Cherrytree56567/Creative-Pad/README.md

# Creative Pad
A simple Macropad which has Hotswap Kailh Switches with custom key binds.

## Features
 - Hotswap Kailh Switches
 - MX Switches
 - RP2040
 - LCD Screen
 - FPC Connector

## Goals
 - Proper support with Ableton
