Cherrytree56567/Creative-Pad/src/KiCad/3dmodels/KH-TYPE-C-16P.step

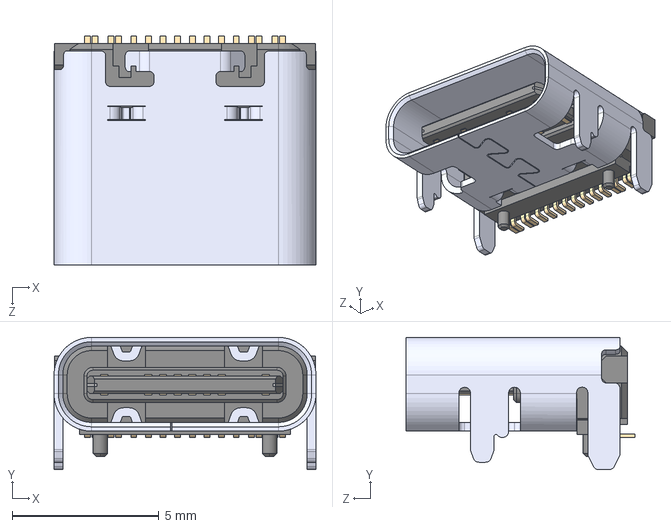
[picture p1: CAD file, 2025-08-07]
src/KiCad/3dmodels/KH-TYPE-C-16P.step
8.94 x 4.51 x 7.81 mm
