Cherrytree56567/Creative-Pad/src/KiCad/3dmodels/USB4110GFA.step

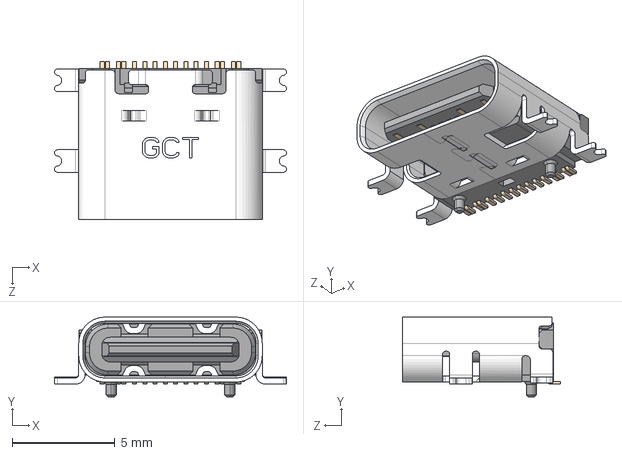
[picture p2: CAD file, 2025-08-07]
src/KiCad/3dmodels/USB4110GFA.step
11.3 x 3.89 x 7.70 mm
