Cherrytree56567/Creative-Pad/src/KiCad/3dmodels/RP2040.step

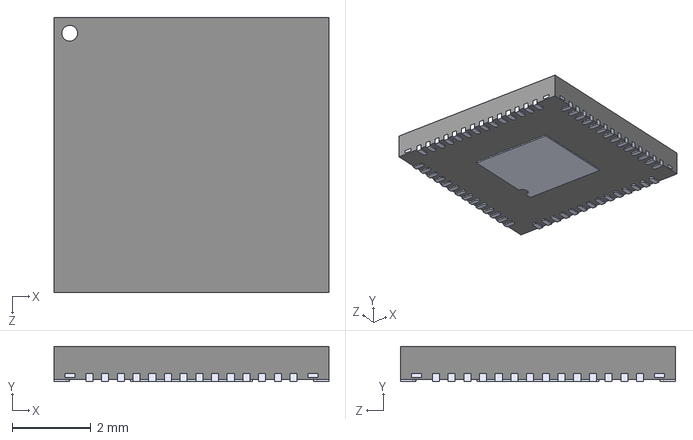
[picture p3: CAD file, 2025-08-07]
src/KiCad/3dmodels/RP2040.step
7.00 x 0.9 x 7.00 mm
