Cherrytree56567/Creative-Pad/schematic.pdf

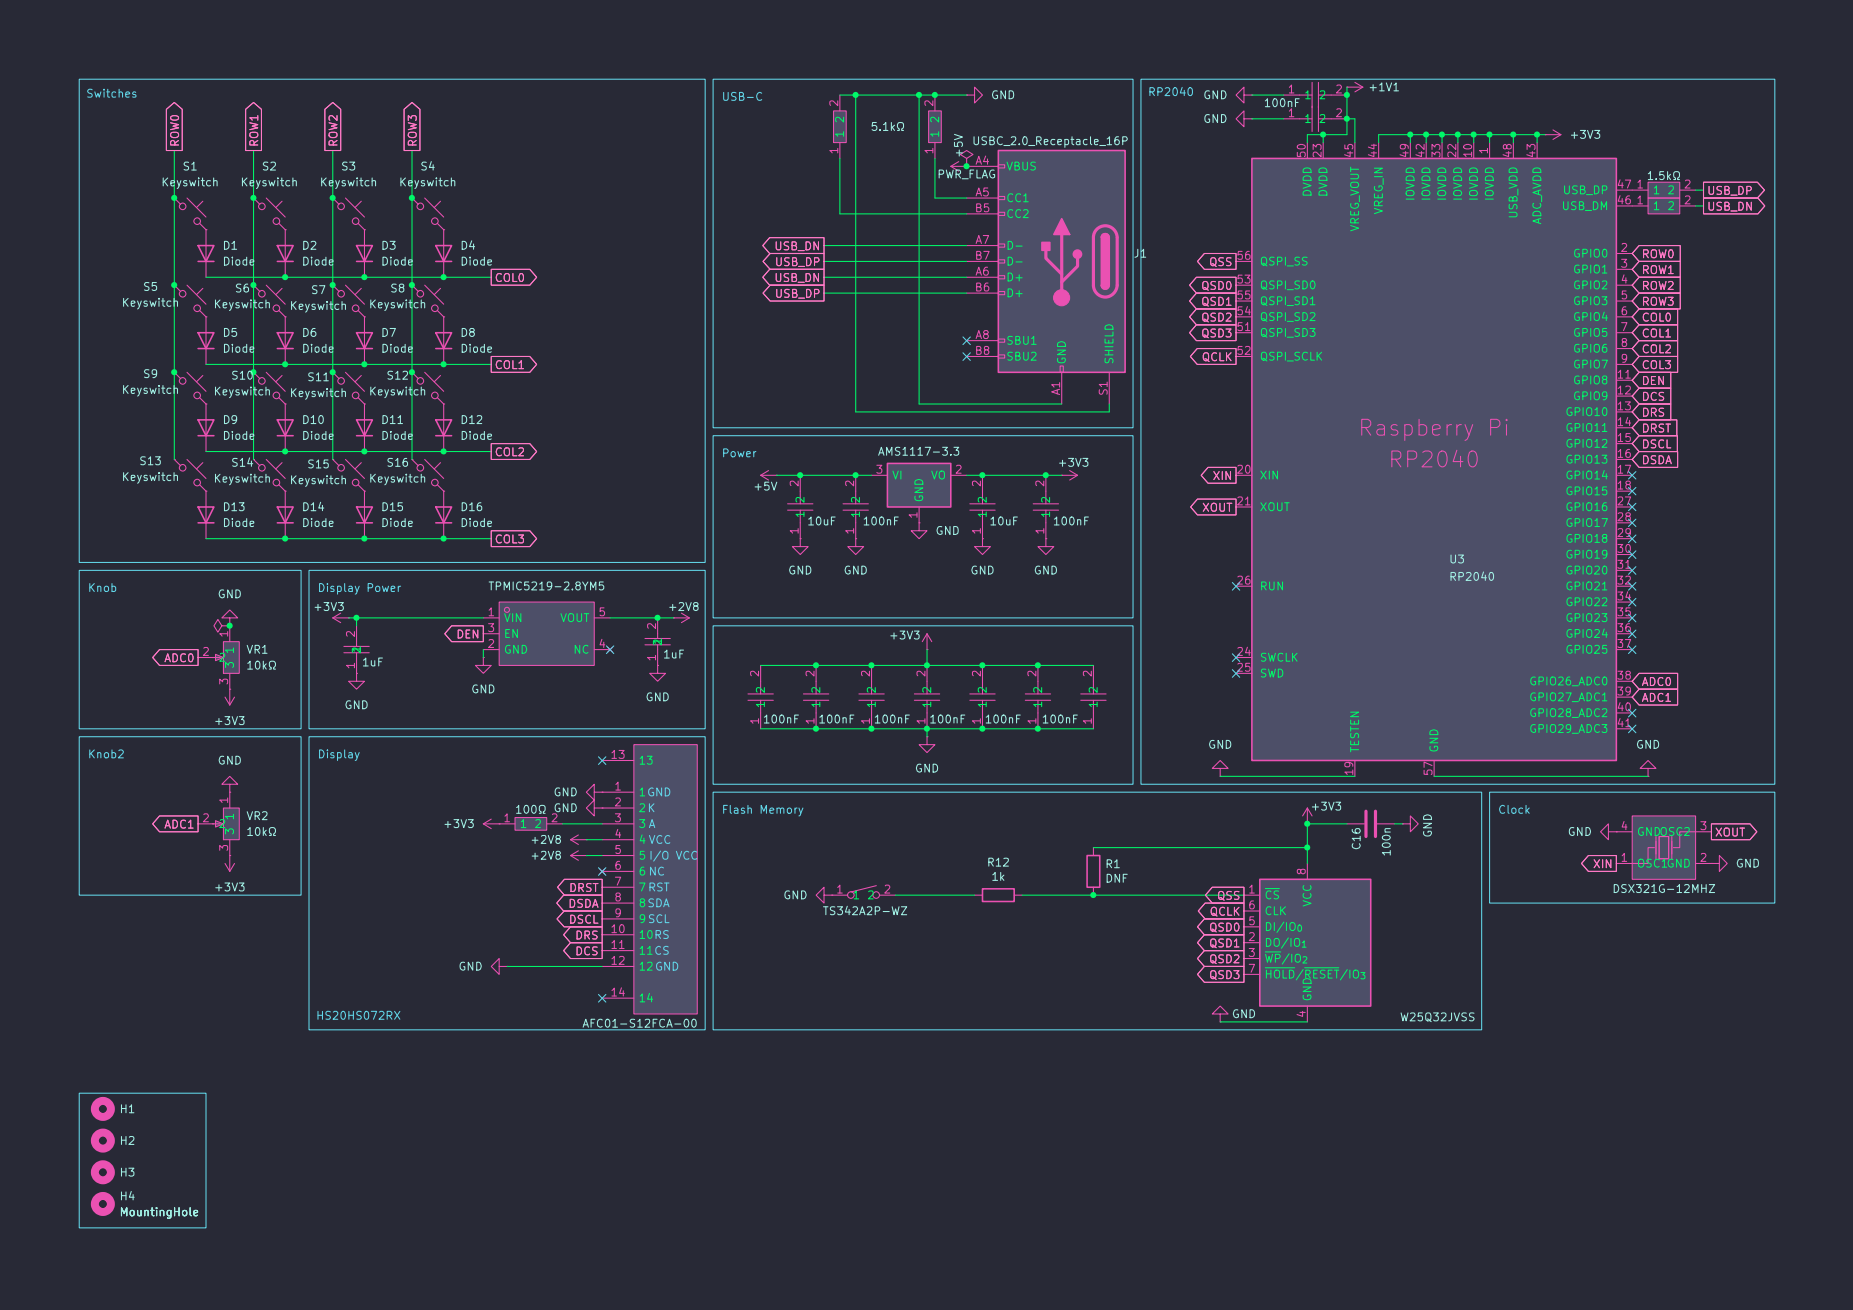
[picture p4: page 1]
