Cherrytree56567/Creative-Pad/src/CreativePad.kicad_pcb

## KiCad design src/CreativePad.kicad_pcb (2025-08-08)

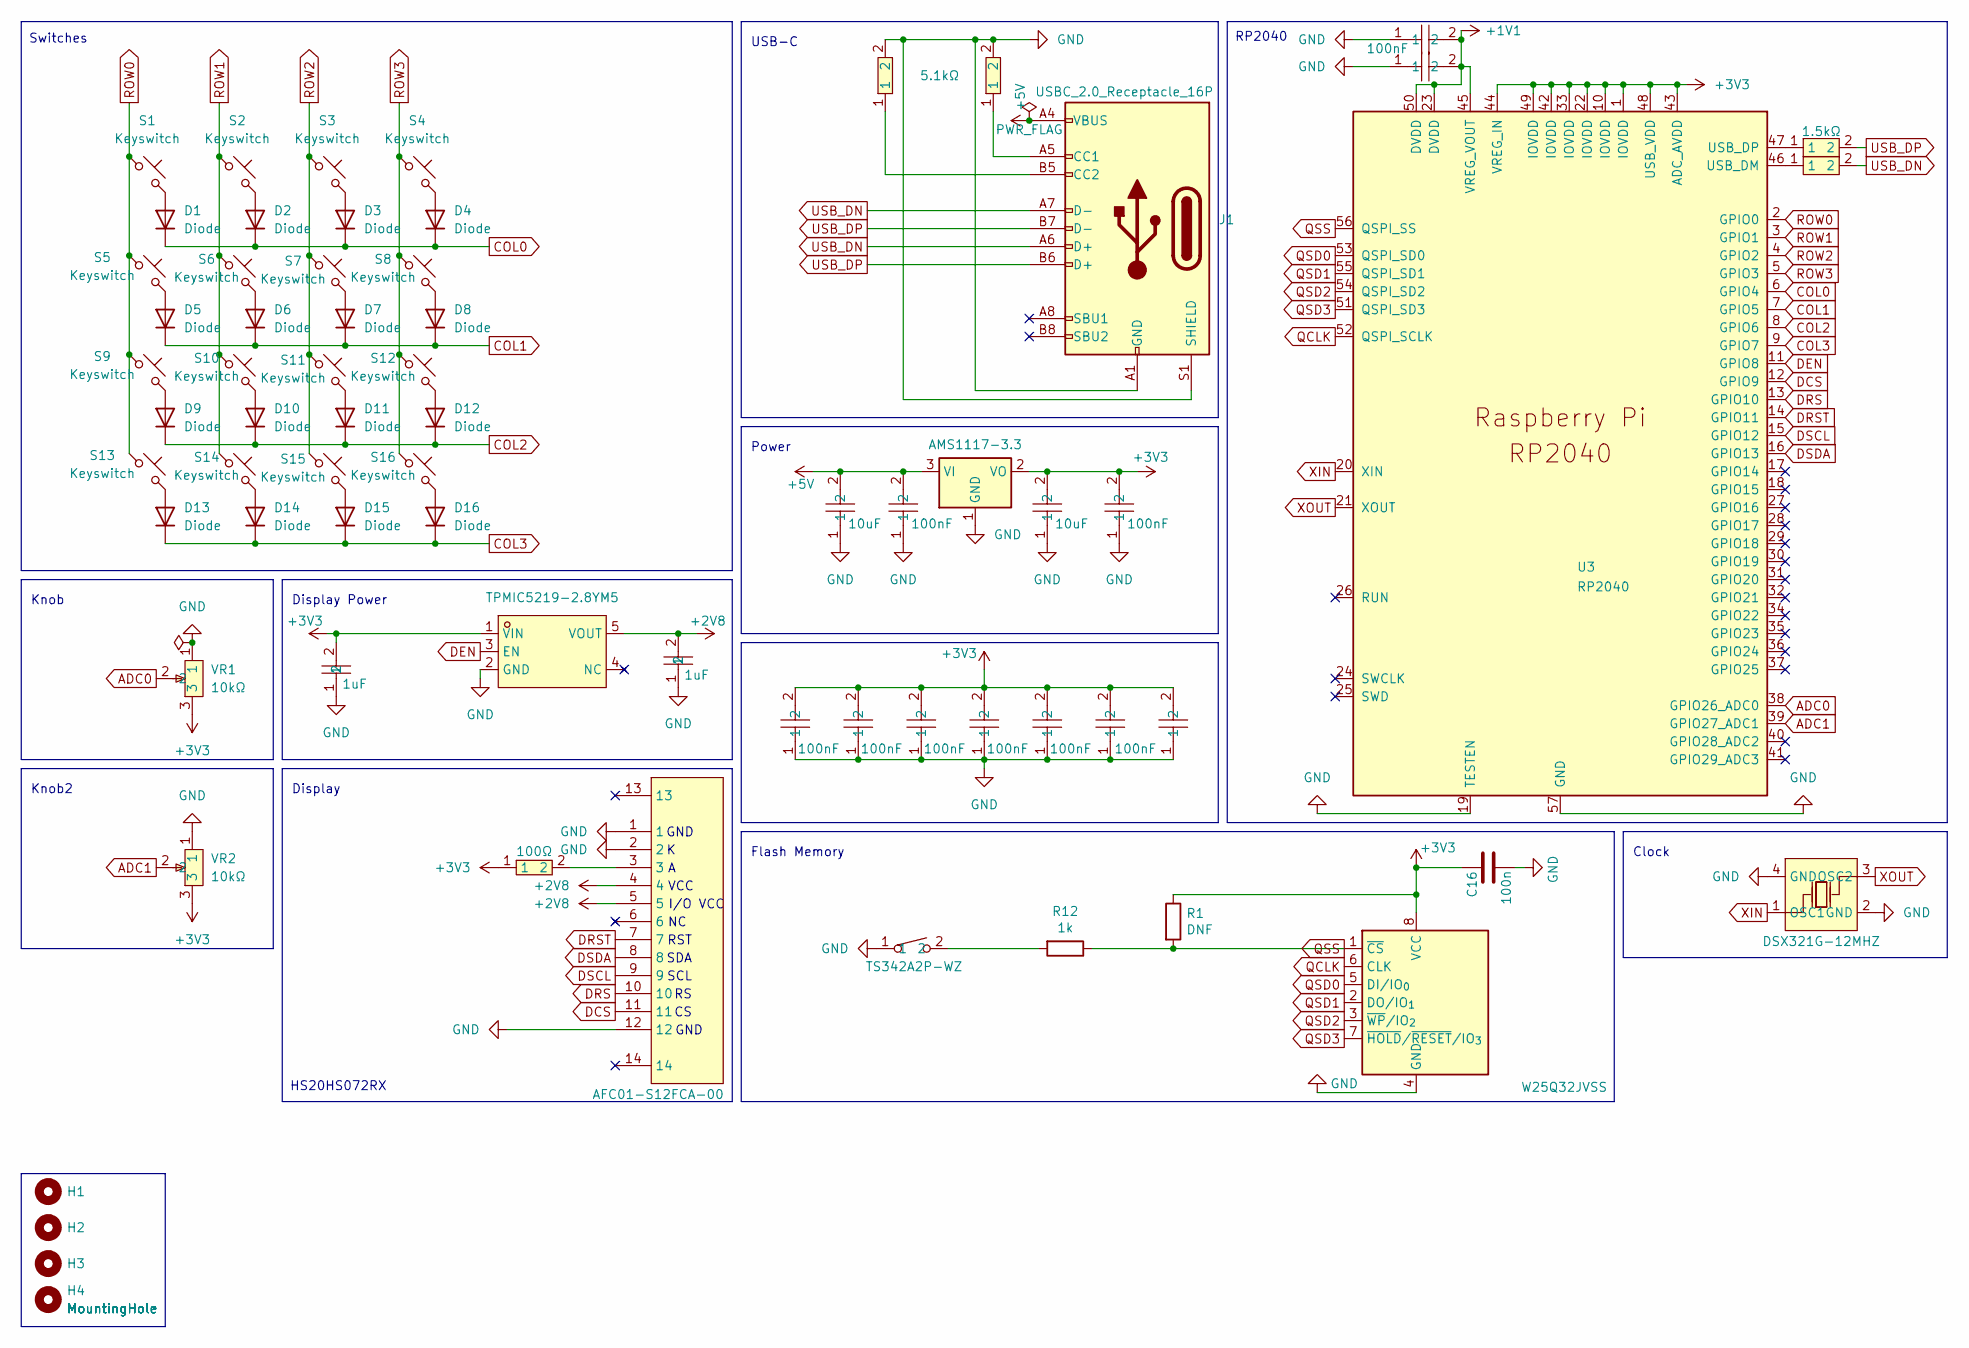
[picture p5: schematic CreativePad.kicad_sch, Creative Pad]

Parts:
C1, C4: 10uF; C0603; LCSC Part C1691
C2, C3, C5, C6, C7, C8, C9, C10, C13, C14, C17: 100nF; C0603; LCSC Part C14663
C12, C15: 1uF; C0402; LCSC Part C14445
C16: 100n; C_0402_1005Metric
D1, D2, D3, D4, D5, D6, D7, D8, D9, D10, D11, D12, D13, D14, D15, D16: Diode; Diode_DO-35
FPC1: AFC01-S12FCA-00; FPC-SMD_AFC01-S12FCA-00; LCSC Part C262661
H1, H2, H3, H4: MountingHole; MountingHole_2.2mm_M2
J1: USBC_2.0_Receptacle_16P; USB_C_Receptacle_HCTL_HC-TYPE-C-16P-01A
R1: DNF; R_0402_1005Metric
R2, R6: 1.5kΩ; R0603; LCSC Part C2907083
R4, R9: 5.1kΩ; R0603; LCSC Part C105580
R8: 100Ω; R0402; LCSC Part C25076
R12: 1k; R_0402_1005Metric
S1, S2, S3, S4, S5, S6, S7, S8, S9, S10, S11, S12, S13, S14, S15, S16: Keyswitch; SW_Hotswap_Kailh_MX_1.00u
SW1: TS342A2P-WZ; SW-SMD_L4.0-W2.9-LS5.0; LCSC Part C557591
U1: TPMIC5219-2.8YM5; SOT-23-5_L2.9-W1.6-P0.95-LS2.8-BR; LCSC Part C18212650
U2: AMS1117-3.3; SOT-223-3_TabPin2
U3: RP2040; RP2040-QFN-56
U5: W25Q32JVSS; SOIC-8_5.3x5.3mm_P1.27mm
VR1, VR2: 10kΩ; RES-ADJ-TH_3362P; LCSC Part C58159
X2: DSX321G-12MHZ; CRYSTAL-SMD_4P-L3.2-W2.5-BL; LCSC Part C93234

Connections:
+1V1: C13.2, C17.2, U3.23 (DVDD), U3.45 (VREG_VOUT), U3.50 (DVDD)
+2V8: C12.2, FPC1.4, FPC1.5, U1.5 (VOUT)
+3V3: C3.2, C4.2, C5.2, C6.2, C7.2, C8.2, C9.2, C10.2, C14.2, C15.2, C16.1, R1.1, R8.1, U1.1 (VIN), U2.2 (VO), U3.1 (IOVDD), U3.10 (IOVDD), U3.22 (IOVDD), U3.33 (IOVDD), U3.42 (IOVDD), U3.43 (ADC_AVDD), U3.44 (VREG_IN), U3.48 (USB_VDD), U3.49 (IOVDD), U5.8 (VCC), VR1.3, VR2.3
+5V: C1.2, C2.2, J1.A4 (VBUS), J1.A9 (VBUS), J1.B4 (VBUS), J1.B9 (VBUS), U2.3 (VI)
ADC0: U3.38 (GPIO26_ADC0), VR1.2
ADC1: U3.39 (GPIO27_ADC1), VR2.2
COL0: D1.1 (K), D2.1 (K), D3.1 (K), D4.1 (K), U3.6 (GPIO4)
COL1: D5.1 (K), D6.1 (K), D7.1 (K), D8.1 (K), U3.7 (GPIO5)
COL2: D9.1 (K), D10.1 (K), D11.1 (K), D12.1 (K), U3.8 (GPIO6)
COL3: D13.1 (K), D14.1 (K), D15.1 (K), D16.1 (K), U3.9 (GPIO7)
DCS: FPC1.11, U3.12 (GPIO9)
DEN: U1.3 (EN), U3.11 (GPIO8)
DRS: FPC1.10, U3.13 (GPIO10)
DRST: FPC1.7, U3.14 (GPIO11)
DSCL: FPC1.9, U3.15 (GPIO12)
DSDA: FPC1.8, U3.16 (GPIO13)
GND: C1.1, C2.1, C3.1, C4.1, C5.1, C6.1, C7.1, C8.1, C9.1, C10.1, C12.1, C13.1, C14.1, C15.1, C16.2, C17.1, FPC1.1, FPC1.2, FPC1.12, J1.A1 (GND), J1.A12 (GND), J1.B1 (GND), J1.B12 (GND), J1.S1 (SHIELD), R4.2, R9.2, SW1.1, U1.2 (GND), U2.1 (GND), U3.19 (TESTEN), U3.57 (GND), U5.4 (GND), VR1.1, VR2.1, X2.2 (GND), X2.4 (GND)
unnamed: D1.2 (A), S1.2
unnamed: D2.2 (A), S2.2
unnamed: D3.2 (A), S3.2
unnamed: D4.2 (A), S4.2
unnamed: D5.2 (A), S5.2
unnamed: D6.2 (A), S6.2
unnamed: D7.2 (A), S7.2
unnamed: D8.2 (A), S8.2
unnamed: D9.2 (A), S9.2
unnamed: D10.2 (A), S10.2
unnamed: D11.2 (A), S11.2
unnamed: D12.2 (A), S12.2
unnamed: D13.2 (A), S13.2
unnamed: D14.2 (A), S14.2
unnamed: D15.2 (A), S15.2
unnamed: D16.2 (A), S16.2
unnamed: FPC1.3, R8.2
unnamed: J1.A5 (CC1), R9.1
unnamed: J1.B5 (CC2), R4.1
unnamed: R12.2, SW1.2
unnamed: R6.1, U3.46 (USB_DM)
unnamed: R2.1, U3.47 (USB_DP)
QCLK: U3.52 (QSPI_SCLK), U5.6 (CLK)
QSD0: U3.53 (QSPI_SD0), U5.5 (DI/IO_{0})
QSD1: U3.55 (QSPI_SD1), U5.2 (DO/IO_{1})
QSD2: U3.54 (QSPI_SD2), U5.3 (~WP/IO_{2})
QSD3: U3.51 (QSPI_SD3), U5.7 (~HOLD/~RESET/IO_{3})
QSS: R1.2, R12.1, U3.56 (QSPI_SS), U5.1 (~CS)
ROW0: S1.1, S5.1, S9.1, S13.1, U3.2 (GPIO0)
ROW1: S2.1, S6.1, S10.1, S14.1, U3.3 (GPIO1)
ROW2: S3.1, S7.1, S11.1, S15.1, U3.4 (GPIO2)
ROW3: S4.1, S8.1, S12.1, S16.1, U3.5 (GPIO3)
USB_DN: J1.A6 (D+), J1.A7 (D-), R6.2
USB_DP: J1.B6 (D+), J1.B7 (D-), R2.2
XIN: U3.20 (XIN), X2.1 (OSC1)
XOUT: U3.21 (XOUT), X2.3 (OSC2)

Notes on the sheet:
VCC
GND
I/O VCC
Knob
HS20HS072RX
Switches
Display
Display Power
Power
Knob2
SCL
RP2040
Flash Memory
USB-C
RST
SDA
Clock

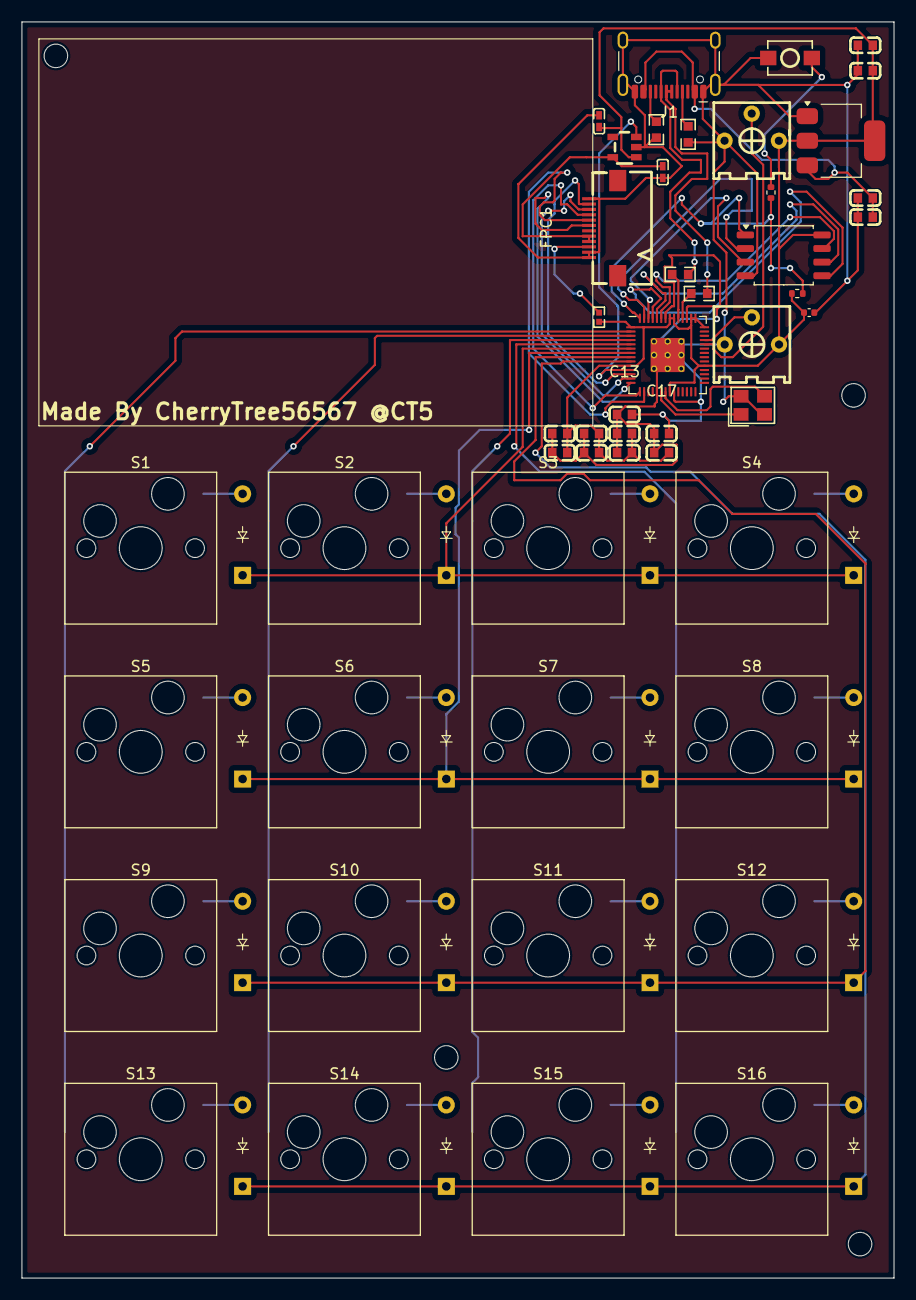
[picture p6: board CreativePad.kicad_pcb from above]

Board: 2 copper layers, 81.6 x 117.5 mm, 69 parts (0 on the bottom side), 53 nets.
