Cherrytree56567/Creative-Pad/(commit log)

2025-07-31 Added Journal
    [CreativePad.kicad_pcb, CreativePad.kicad_sch]
2025-08-02 Day 3
    [CreativePad.kicad_pcb, CreativePad.kicad_sch]
2025-08-03 Day 3-4
    [CreativePad.kicad_pcb, CreativePad.kicad_sch]
2025-08-03 Day 5 - P1
    [CreativePad.kicad_pcb, CreativePad.kicad_sch]
2025-08-04 Day 5
    [CreativePad.kicad_pcb, CreativePad.kicad_sch]
2025-08-06 Day 6
    [CreativePad.kicad_pcb, CreativePad.kicad_sch]
2025-08-07 Day 8
    [CreativePad.kicad_pcb, CreativePad.kicad_sch, RP2040.step]
2025-08-07 Day 8 - Part 2
    [CreativePad.kicad_pcb, CreativePad.kicad_sch, USB4110GFA.step]
2025-08-07 Added 3D Model
    [CreativePad.kicad_pcb, KH-TYPE-C-16P.step]
2025-08-07 Fixed Model (FPC)
    [CreativePad.kicad_pcb]
2025-08-08 Day 9
    [CreativePad.kicad_pcb, CreativePad.kicad_sch]
2025-08-15 Day 13 - 14
    [bom.csv, designators.csv, positions.csv]
2025-08-28 Added STL
